Kn0ww/Sistema-de-riego-inteligente-por-zonas/README.md

# Sistema de riego inteligente por zonas
IoT-e1736873173433

## Objetivo
Diseñar e implementar un sistema de riego automático basado en IoT, capaz de monitorear la humedad del suelo y controlar el riego de manera independiente para 2 ZONAS validada por el docente de la sección.

## Integrantes
- David Morales  
- Alex Camacaro
- Sofia Aedo
- Mauricio Lobo
- Xavier Lopez
- Cristobal Barahona
  
## Hardware
- Microcontrolador ESP32
- 2 sensores de humedad HD-38
- Relé de 4 canales HW-316
- Mini bomba de agua R385 DC 5V
- Pantalla Oled 1.3 128x64 caracteres blancos
- Servomotor SG90
  
## Software
- Arduino IDE
- Mosquitto
- Telegraf
- InfluxDB
- Grafana
- Python + Pandas
- Node-RED

## Ventana del filtro
- N: 5, Se seleccionó porque para el sistema de riego se mide la humedad del suelo cada 60 segundos. La ventana de cinco muestras permite suavizar variaciones y ruido del sensor considerando aproximadamente cinco minutos de mediciones, sin generar un retraso excesivo para la decisión del riego.

## Sensores
- El valor de 0% a 100% que mostramos no es el porcentaje de volumen de agua real. Es un índice
relativo basado en la resistencia eléctrica del sustrato.
## Electrolisis
Para evitar la electrólisis, los sensores no quedan energizados permanentemente:
- Se alimentan directo desde un pin GPIO del ESP32 solo durante la medición, con 300 ms de estabilización previa, permaneciendo apagados el 99% del tiempo.
- Justificación de corriente: El sensor HD-38 consume ~10 mA al medir, valor muy inferior al límite seguro de 20-40 mA que entrega un pin GPIO del ESP32, operando con amplia holgura y haciendo innecesario un transistor externo.

## Verificación sensor simulado
| Parámetro | Simulación (GT1) | 
|---|---|
| m (ganancia) | 0.94883 |
| b (offset) | -1.955 |
| Tercer punto | dentro de tol. | 
---------------------------------------
- Tolerancia declarada sensor simulado: ±0.5 °C

## Sistema de riego

- Sensor: humedad de suelo resistivo | Familia: A 
- Referencia: dos condiciones conocidas, aire (0 %) y agua (100 %)
- Porcentaje humedad sensores(%): El sensor entrega un índice relativo de humedad para nuestro sustrato.
- Referencia validada por: docente de la sección
## Condiciones de la medición 
| Condición | Valor declarado |
|---|---|
| Tensión de alimentación MEDIDA | 3,2V (verificado con multímetro) |
| Canales empleados | Z1: GPIO 35, Z2: GPIO 34 |
| Atenuación del convertidor | 11 dB, lectura en mV calibrados de fabrica |
| Divisor a la entrada | NO se emplea (Porque el sensor se alimenta de 3,3V, por lo que la salida se mantiene dentro del rango considerado utilizable por el ADC en esta configuración) |
| Lectura en aire dentro de la zona útil | si |
| Tiempo de estabilización en cada punto | 10 s |
| Sustrato de cada zona | Z1: tierra  Z2: tierra |
| Profundidad de inserción | hasta 8cm |
| Temperatura ambiente | 20°C |
| N de la media móvil | 5 |

## Tolerancia declarada
| Criterio | Tolerancia aceptada |
|---|---|
| Dispersión aceptada en condición estable, por zona | ± 2% |
| Separación mínima exigida entre aire y agua | 1000mV |
| Reproducibilidad del punto de agua entre repeticiones | +/- 60 mV |

## Calibración de dos puntos
| Zona | mV en tierra seca | mV en tierra humeda | Separación (mV) | m (%/mV) | b (%) |
|---|---|---|---|---|---|
| 1 | 1060.1  | 420.4 | 639.7 | -0.156321  | 165.7188 |
| 2 | 1138.9  | 462.4 | 676.5 | -0.147820  | 168.3548 |

La pendiente m es NEGATIVA en ambas zonas: a mayor humedad, menor lectura.

## Reproducibilidad del punto de tierra humeda 
| Zona | Repetición 1 (mV) | Repetición 2 (mV) | Diferencia | Cabe en la tolerancia |
|---|---|---|---|---|
| 1 | 323 |  270 | 53 | si |
| 2 | 506 |  502 | 4 | si |

## Verificación en el tercer punto (tierra húmeda)
| Zona | mV  | Porcentaje (%) | Valor SIN recortar | Estable y repetible |
|---|-----|---|---|---|
| 1 | 782  | 71.3 | N/A | si |
| 2 | 719 | 62.1 | N/A | si |

## Dispersión medida 
| Zona | Condición registrada | Media (%) | Dispersión (%) | Banda minima (k x disp) |
|---|---|---|---|---|
| 1 | tierra humeda | 71.3 | 0.28 | 0.84 |
| 2 | tierra humeda | 62.1 | 0.20 | 0.60 |

- k declarado: 3

## Contraste con la GT1
| Aspecto | Simulacion (GT1) | Fisico (S4) |
|---|---|---|
| Origen del error | sembrado | propio de cada ejemplar |
| Numero de pares | 1 | 2, uno por zona |
| Desviacion observada | --- | <diferencia entre los tres pares> |

## Hallazgo del equipo
A partir de los ensayos realizados en condición de tierra húmeda, se registraron las siguientes métricas de dispersión y respuesta:

- Diferencia de medias: Se observó una separación de 9,2 puntos porcentuales entre la Zona 1 (71,3 %) y la Zona 2 (62,1 %).
- Dispersión observada: La Zona 2 presentó una dispersión de 0,28 %, mientras que la Zona 1 registró 0,20 %.
- Banda mínima teórica (k = 3):
  * Zona 1: 3 * 0,20 % = 0,60 %
  * Zona 2: 3 * 0,28 % = 0,84 %

Inicialmente se consideró necesario establecer una banda de histéresis diferenciada por zona debido a la discrepancia de dispersión entre ambos ejemplares. No obstante, en el firmware se implementó una banda de histéresis común de 10 puntos porcentuales (10 %) para ambas zonas.

Justificación técnica de la banda común en firmware:
Al contrastar la banda de 10 % del firmware frente al requerimiento teórico de cada sensor:
- En la Zona 1: 10 % / 0,60 % = 16,67 veces (~17 veces el mínimo requerido).
- En la Zona 2: 10 % / 0,84 % = 11,90 veces (~12 veces el mínimo requerido).

La banda configurada supera entre 12 y 17 veces el mínimo exigido por la dispersión experimental. Dado este amplio margen de holgura, cualquier fluctuación espuria o ruido de medición queda plenamente absorbido, evitando oscilaciones en la conmutación del actuador y la bomba sin necesidad de complejizar el firmware con umbrales independientes.

### Limitaciones registradas
- La escala construida vale para el ejemplar, el sustrato Y la profundidad de
  insercion declarados. Cambiar cualquiera de los tres obliga a recalibrar.
- La lectura se toma en milivolts calibrados de fabrica. El convertidor del
  ESP32 responde de forma util entre unos 150 y 2450 mV: fuera de ese rango la
  medicion se comprime o se recorta.
  
- El porcentaje informado es una posicion relativa entre aire y agua, no unM
  contenido volumetrico de agua medido contra patron.
- La dispersion registrada corresponde a la condicion declarada. En otra
  condicion, la dispersion puede ser distinta.
- P8 es un prototipo educativo.

## Tabla de Tópicos MQTT
| Nombre del Tópico | QoS | Retained | Descripción del Payload |
| :--- | :---: | :---: | :--- |
| `curso/E03/P08/nodo1` | 0 | True | Payload JSON plano con los datos de humedad calibrados y estados de las zonas Z1/Z2. |
| `curso/E03/P08/nodo1/estado` | 1 | True | Mensaje de texto plano indicando el estado de conexión. (Online, OfFline) |
| `curso/E03/P08/nodo1/cmd` | 1 | False | Reservado para la recepción de comandos de control entrantes (formato JSON). |

## Informacion Telegraf

```text
ESP32 -> MQTT -> Mosquitto -> Telegraf -> InfluxDB -> Grafana
```

1. El ESP32 obtiene las mediciones de los sensores.
2. Las mediciones se publican mediante MQTT.
3. Mosquitto recibe los mensajes MQTT.
4. Telegraf consume los tópicos MQTT y procesa los datos.
5. Telegraf almacena los datos en InfluxDB.
6. Grafana consulta InfluxDB para visualizar las métricas.

```text
Bucket: mediciones
Measurement: mediciones
```

| Tag | Valor |
| :--- | :--- |
| `equipo` | `E03` |
| `proyecto` | `P08` |
| `nodo` | `nodo1` |

## Fields del Proyecto

| Field | Descripción |
| :--- | :--- |
| `humedad_z1` | Humedad medida en la zona 1. |
| `humedad_z2` | Humedad medida en la zona 2. |
| `estado_z1` | Estado actual de la zona 1. |
| `estado_z2` | Estado actual de la zona 2. |
| `rssi_dbm` | Intensidad de la señal WiFi recibida por el ESP32 en dBm. |
