Kn0ww/Sistema-de-riego-inteligente-por-zonas/docs/Grafo de estados .png

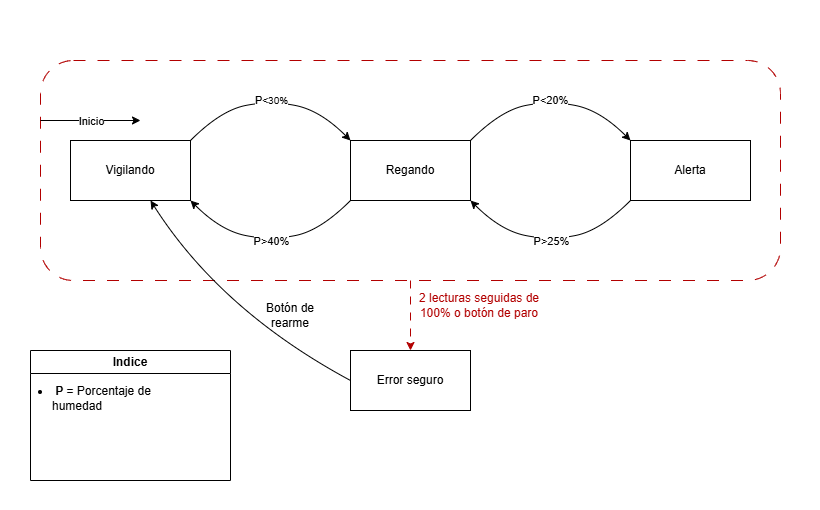
docs/Grafo de estados .png
