Kn0ww/Sistema-de-riego-inteligente-por-zonas/docs/InfografanaGT5.png

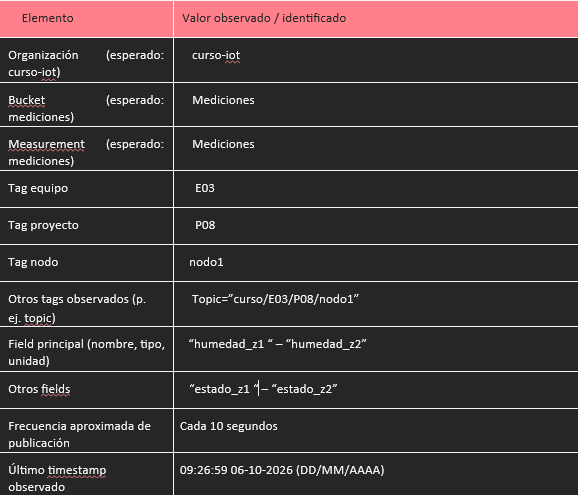
docs/InfografanaGT5.png
