Kn0ww/Sistema-de-riego-inteligente-por-zonas/docs/S3_Ficha_alimentacion_nodo_Rev.xlsx

Sheet: Instrucciones
FICHA DE ALIMENTACIÓN DEL NODO — GT1, ítem 7
Fundamentos de IoT · 2º semestre 2026 · Universidad Autónoma de Chile
QUÉ SE COMPLETA
Solo las celdas con fondo azul de la hoja «Ficha». Todo lo demás son fórmulas: no se escribe encima.
PASOS
1. Completar la identificación del equipo y los parámetros del ciclo (período, rieles, batería).
2. Listar TODOS los componentes del nodo, uno por fila, con su corriente activa, su corriente en reposo y
cuántos segundos permanece activo dentro de un período. La fila de ejemplo muestra el formato esperado:
bórrenla o sustitúyanla por sus propios componentes.
3. Indicar de dónde salió cada cifra: hoja de datos del componente o medición propia. Un número sin fuente
no se acepta en el ítem 7.
4. Registrar la corriente de pico de cada componente. La planilla identifica sola cuál domina.
5. Declarar si el nodo va enchufado o a batería, y justificarlo en una línea.
6. Guardar la planilla en la carpeta /docs del repositorio del equipo.
CÓMO SE CALCULA
Corriente media ponderada por el ciclo de trabajo: I_media = Σ [ I_activa·t_activo + I_reposo·(T − t_activo) ] / T
Corriente exigida a la batería con conversión reductora: I_bat = I_media · (V_riel / V_bat) / η
Autonomía: t = (0,8 · C_nominal) / I_bat (el factor 0,8 es la capacidad útil, no la nominal)
ADVERTENCIAS QUE CUESTAN EL ÍTEM
· La corriente de pico no es opcional: es la que reinicia el nodo cuando transmite. Sin ella, el ítem 7 no cumple.
· El consumo en reposo de una PLACA DE DESARROLLO es de unidades de mA, no de microamperios. Usar la cifra del
módulo desnudo produce una autonomía entre diez y cien veces optimista.
· Una celda 18650 que declara más de 3500 mAh no es creíble. Usar una capacidad defendible y anotar el supuesto.
· Si el proyecto exige nodo publicando de forma permanente (Semana 10), la autonomía debe ser compatible con eso
o el nodo va enchufado. Decidirlo ahora es más barato que descubrirlo en la Semana 10.

Sheet: Ficha
FICHA DE ALIMENTACIÓN DEL NODO
Completar solo las celdas con fondo azul. GT1, ítem 7.
Equipo (código E NN) | E03
Proyecto (código P NN) | P8
Sección de laboratorio | LAB 01
Fecha | 2026-08-14
PARÁMETROS DEL CICLO Y DE LA FUENTE
Período del ciclo del nodo T [s] | 60 | Tiempo entre dos mediciones completas.
Tensión del riel principal V_riel [V] | 5 | Riel que alimenta el nodo.
Tensión nominal de la batería V_bat [V] | 7.4 | 2 celdas 18650 en serie = 7,4 V.
Rendimiento del conversor η | 0.85 | Conversor reductor. 0,85 es un valor conservador.
Capacidad nominal de la batería C_nom [mAh] | 2600 | Capacidad defendible, no la de la etiqueta si es implausible.
Factor de capacidad útil | 0.8 | No se descarga una celda al 100 %.
CONSUMO POR COMPONENTE
Componente | Riel [V] | I activa [mA] | I reposo [mA] | t activo por ciclo [s] | I de pico [mA] | Aporte a I media [mA] | Fuente del dato | ¿Riel propio?
ESP32 DevKit — CPU activa, radio apagada | 5 V | 120 | 10 | 60 | 300 | 120.00 | Hoja de datos del módulo | No
Sensor de humedad HD-38 | 3,3V | 30 | 0 | 10 | 30 | 5.00 | Especificaciones MechatronicStore | No
Sensor de humedad HD-38 | 3,3V | 30 | 0 | 10 | 30 | 5.00 | Especificaciones MechatronicStore | No
Pantalla OLED | 3V | 10 | 1.5 | 10 | 30 | 2.92 | Especificaciones AFEL | No
Relé SRD-05VDC-SL-C | 5V | 89.3 | 0 | 10 | 89.3 | 14.88 | Datasheet SRD-05VDC-SL-C: | No
Mini bomba de agua | 5V | 220 | 0 | 10 | 600 | 36.67 | Especificaciones MCI Electronics | Si
Servomotor SG90 9g | 5V | 220 | 0 | 2 | 650 | 7.33 | Datasheet SG90 9g | Si
RESULTADOS
Corriente media del nodo I_media [mA] | 191.80
Corriente de pico máxima [mA] | 650
Componente que produce el pico | Servomotor SG90 9g
Corriente exigida a la batería I_bat [mA] | 152.46
Capacidad útil [mAh] | 2080
Autonomía estimada [h] | 13.6
Autonomía estimada [días] | 0.6
DECISIÓN DE ALIMENTACIÓN
¿El nodo va enchufado o a batería? | Batería
Justificación en una línea | Se utiliza batería ya que permite que el sistema de riego sea autónomo y portátil, evitando depender de un enchufe cercano.
¿Hay actuadores con riel propio? ¿Cuáles? | Si hay actuadores con riel propio. el Servo motor y Mini Bomba de agua utilizan un riel de 5 V.
¿Usa deep sleep? ¿Es compatible con la publicación permanente (S10)? | No usaremos deep sleep, ya que usaremos comandos remotos de riego Node-RED, por lo que requerimos que el nodo permaneza despierto todo el tiempo.
Supuestos declarados (capacidad de celda, consumo en reposo, etc.) | Servo motor (t_activo por ciclo [s] = 2 s), Mini bomba (t_activo por ciclo [s] = 10 s), Rele (t_activo por ciclo [s] = 10 s), Pantalla LCD (I reposo) se contemplo que cuando el LCD esta activo con la luz tiene esas especificaciones pero cuando no la corriente baja a 1,5 por lo que se considero en reposo ya que no estara activo o al menos activo con luz como se espera. Otro supuesto el ESP32 ya que no teniamos el modelo por ende usamos por referencia.
Nota: las cifras de la fila de ejemplo son órdenes de magnitud para ilustrar el formato. Cada equipo debe sustituirlas por los valores de la hoja de datos de sus propios componentes o por mediciones propias, indicando la fuente.

Sheet: Referencia
ÓRDENES DE MAGNITUD DE CONSUMO (referencia para dimensionar)
Valores de orden de magnitud, no de diseño. El valor definitivo se toma de la hoja de datos del componente del kit y se registra con su fuente.
Componente | Corriente típica | Comentario
ESP32 DevKit — CPU activa, radio apagada | decenas de mA | Estado habitual entre muestras.
ESP32 — transmisión WiFi | picos de cientos de mA | Pico de milisegundos; es el que reinicia nodos mal alimentados.
ESP32 DevKit — deep sleep | unidades de mA | El conversor USB-serie y el LED de la placa siguen consumiendo.
Módulo ESP32 desnudo — deep sleep | decenas de µA | No usar esta cifra si el proyecto usa placa de desarrollo.
Sensor digital de temperatura/humedad | 1–2 mA al medir | Despreciable frente al resto.
Sensor ultrasónico | ~15 mA | Solo durante la medición.
Pantalla OLED | 10–20 mA | Continuo mientras esté encendida.
Sensor de gas con calefactor (familia MQ) | ~150 mA continuos | Domina el presupuesto; incompatible con batería pequeña.
Módulo de relé (una bobina) | ~70 mA por canal | Se multiplica por canal simultáneo.
Servomotor pequeño | decenas de mA en reposo; cientos en movimiento | Pico de arranque muy superior al promedio. Riel propio.
Electroválvula solenoide 12 V | cientos de mA mientras está abierta | Riel propio; no accionar varias en simultáneo.
Módulo de cámara | cientos de mA en transmisión | Causa clásica de reinicio por caída de riel.
Fuente: hojas de datos de los fabricantes de los componentes del kit y cápsula asincrónica «Alimentación del nodo» (Semana 3).
