Kn0ww/Sistema-de-riego-inteligente-por-zonas/code/FSM_1_Zona.ino

/* =========================================================================
   PROYECTO: Sistema de Riego Automatizado con ESP32
   FSM:
   VIGILANDO
      P < 30%  -> REGANDO
   REGANDO
      P > 40%  -> VIGILANDO
      P < 20%  -> ALERTA
   ALERTA
      P > 25%  -> REGANDO
   ERROR_SEGURO
      2 lecturas seguidas al 100% o botón de paro
      botón de rearme -> VIGILANDO
========================================================================= */
#include <Wire.h>
#include <LiquidCrystal_I2C.h>
// ==========================================================================
// 1. PINES
// ==========================================================================
const uint8_t PIN_SENSOR_HUMEDAD = 34;  // ADC1
const uint8_t PIN_ENERGIA_SENSOR = 32;  
const uint8_t PIN_RELE           = 26;
const uint8_t PIN_LED_VERDE      = 14;
const uint8_t PIN_LED_ROJO       = 27;
const uint8_t PIN_BUZZER         = 25;
const uint8_t PIN_BOTON          = 33;
// ==========================================================================
// 2. RELÉ
// ==========================================================================
const uint8_t RELE_ON  = LOW; // LOW  = relé activado
const uint8_t RELE_OFF = HIGH; // HIGH = relé desactivado
// 3. LCD
// ==========================================================================
LiquidCrystal_I2C lcd(0x27, 16, 2);
// ==========================================================================
// 4. ADQUISICIÓN Y FILTRADO
// ==========================================================================
// Periodo de muestreo: 60000 ms = 1 minuto
const uint8_t N_FILTRO = 5; // Media móvil de 5 muestras
// Calibración de sensor -> % = M * mV + B
const float M = -0.0454236f;
const float B = 141.9032f;
// Rango útil observado en la calibración
const int MV_MAXIMO_UTIL = 2450;
const int MV_MINIMO_UTIL = 150;
// ==========================================================================
// 5. UMBRALES DE LA FSM
// ==========================================================================
const float P_VIGILANDO_REGANDO = 30.0f;
const float P_REGANDO_VIGILANDO = 40.0f;

const float P_REGANDO_ALERTA    = 20.0f;
const float P_ALERTA_REGANDO    = 25.0f;
// ==========================================================================
// 6. MÁQUINA DE ESTADOS
// ==========================================================================
enum Estado : uint8_t {
  VIGILANDO,
  REGANDO,
  ALERTA,
  ERROR_SEGURO
};
Estado estado = VIGILANDO;
// ==========================================================================
// 7. TEMPORIZACIÓN
// ==========================================================================
uint32_t t_entrada = 0; // Marca guardada al entrar al estado.
uint32_t t_sensor = 0; // Temporización del sensor
uint32_t t_boton = 0; // Temporización del botón para antirrebote
const uint32_t DEBOUNCE_MS = 50;
uint32_t t_buzzer = 0; // Temporización del buzzer
const uint32_t PERIODO_BUZZER_MS = 300;
bool buzzerEstado = false;
uint32_t t_lcd = 0;
const uint32_t PERIODO_LCD_MS = 250;
// ==========================================================================
// 8. FILTRO
// ==========================================================================
int ventana[N_FILTRO] = {0};
uint8_t indiceFiltro = 0;
bool filtroLleno = false;
// ==========================================================================
// 9. VARIABLES DEL SENSOR Y SUB-MÁQUINA
// ==========================================================================
enum EstadoSensor : uint8_t {
  SENSOR_REPOSO,
  SENSOR_ESPERANDO_300MS
};

EstadoSensor estadoSensor = SENSOR_REPOSO;
uint32_t t_encendido_sensor = 0;

int lecturaCruda_mV = 0;
int lecturaFiltrada_mV = 0;

float humedadPorcentaje = 0.0f;
float humedadSinRecortar = 0.0f;
// ==========================================================================
// 10. ERROR POR PERSISTENCIA
uint8_t lecturas100 = 0; // Se necesitan 2 lecturas consecutivas al 100%.
// ==========================================================================
// 11. ESTADO DEL BOTÓN
bool botonEstable = HIGH;
bool botonAnterior = HIGH;
// ==========================================================================
// 12. LEER SENSOR EN mV
int leer_mV() {
  long suma = 0;
  // Promedio de 8 lecturas para reducir variación instantánea
  for (uint8_t i = 0; i < 8; i++) {
    suma += analogReadMilliVolts(PIN_SENSOR_HUMEDAD);
  }
  return (int)(suma / 8);
}
// ==========================================================================
// 13. FILTRO DE MEDIA MÓVIL
// ==========================================================================
int filtrar(int valor) {
  ventana[indiceFiltro] = valor;

  indiceFiltro = (indiceFiltro + 1) % N_FILTRO;
  if (indiceFiltro == 0) {
    filtroLleno = true;
  }
  uint8_t cantidad;
  if (filtroLleno) {
    cantidad = N_FILTRO;
  } else {
    cantidad = indiceFiltro;
  }
  if (cantidad == 0) {
    cantidad = 1;
  }
  long suma = 0;
  for (uint8_t i = 0; i < cantidad; i++) {
    suma += ventana[i];
  }
  return (int)(suma / cantidad);
}
// ==========================================================================
// 14. CONVERSIÓN mV -> PORCENTAJE
// ==========================================================================
float convertirPorcentaje(int mv) {
  float porcentaje = M * mv + B;   // Guardamos el valor sin limitar para diagnóstico
  humedadSinRecortar = porcentaje;
  if (porcentaje < 0.0f) {  // Limitar al rango 0 ... 100 %
    porcentaje = 0.0f;
  }
  if (porcentaje > 100.0f) {
    porcentaje = 100.0f;
  }
  return porcentaje;
}
// ==========================================================================
// 15. NOMBRE DEL ESTADO
// ==========================================================================
const char* nombreEstado(Estado e) {
  switch (e) {
    case VIGILANDO:
      return "VIGILANDO";
    case REGANDO:
      return "REGANDO";
    case ALERTA:
      return "ALERTA";
    case ERROR_SEGURO:
      return "ERROR_SEGURO";
  }
  return "DESCONOCIDO";
}
// ==========================================================================
// 16. CAMBIO DE ESTADO
// ==========================================================================
void cambiar(Estado nuevoEstado) { // ÚNICA función que cambia "estado". También reinicia el temporizador de entrada.
  if (estado == nuevoEstado) {
    return;
  }
  estado = nuevoEstado;
  t_entrada = millis(); // Marca de entrada al nuevo estado
  t_buzzer = millis(); // Reiniciar temporizador del buzzer
  buzzerEstado = false;
  digitalWrite(PIN_BUZZER, LOW);
  Serial.print("[");
  Serial.print(millis());
  Serial.print(" ms] -> ");
  Serial.println(nombreEstado(estado));
}
// =========================================================================
// 17. BOTÓN CON ANTIRREBOTE
// ==========================================================================
bool botonPresionado() {
  bool lectura = digitalRead(PIN_BOTON);
  if (lectura != botonAnterior) {
    t_boton = millis();
    botonAnterior = lectura;
  }
  if (millis() - t_boton >= DEBOUNCE_MS) {   // Esperar solamente mediante millis()
    if (lectura != botonEstable) {
      botonEstable = lectura;
      if (botonEstable == LOW) {  // LOW = botón presionado
        return true;
      }
    }
  }
  return false;
}
// ==========================================================================
// 18. BUZZER INTERMITENTE
// ==========================================================================
void buzzerIntermitente() {
  uint32_t ahora = millis();
  if (ahora - t_buzzer >= PERIODO_BUZZER_MS) { // Temporización no bloqueante
    t_buzzer = ahora;
    buzzerEstado = !buzzerEstado;
    digitalWrite(PIN_BUZZER, buzzerEstado);
  }
}
// ==========================================================================
// 19. ACTUADORES
// ==========================================================================
void actualizarActuadores() {
  switch (estado) {
    case VIGILANDO: // VIGILANDO
      digitalWrite(PIN_RELE, RELE_OFF);
      digitalWrite(PIN_LED_VERDE, HIGH);
      digitalWrite(PIN_LED_ROJO, LOW);
      digitalWrite(PIN_BUZZER, LOW);
      break;
    case REGANDO: // REGANDO
      digitalWrite(PIN_RELE, RELE_ON);
      digitalWrite(PIN_LED_VERDE, HIGH);
      digitalWrite(PIN_LED_ROJO, LOW);
      digitalWrite(PIN_BUZZER, LOW);
      break;
    case ALERTA: // ALERTA
      digitalWrite(PIN_RELE, RELE_ON);
      digitalWrite(PIN_LED_VERDE, LOW);
      digitalWrite(PIN_LED_ROJO, HIGH);
      buzzerIntermitente();
      break;
    case ERROR_SEGURO: // ERROR SEGURO
      // Salida segura:
      // relé apagado
      digitalWrite(PIN_RELE, RELE_OFF);
      digitalWrite(PIN_LED_VERDE, LOW);
      digitalWrite(PIN_LED_ROJO, HIGH);
      buzzerIntermitente();
      break;
  }
}
// ==========================================================================
// 20. LCD
// ==========================================================================
void actualizarLCD() {
  uint32_t ahora = millis();

  if (ahora - t_lcd >= PERIODO_LCD_MS) {  // Temporizador del LCD
    t_lcd = ahora;
    lcd.setCursor(0, 0);     // Primera fila
    lcd.print("Humedad: ");
    lcd.print(humedadPorcentaje, 1);
    lcd.print("%   ");

    lcd.setCursor(0, 1);     // Segunda fila
    switch (estado) {
      case VIGILANDO:
        lcd.print("Vigilando      ");
        break;
      case REGANDO:
        lcd.print("Regando        ");
        break;
      case ALERTA:
        lcd.print("ALERTA         ");
        break;
      case ERROR_SEGURO:
        lcd.print("ERROR SEGURO   ");
        break;
    }
  }
}
// ==========================================================================
// 21. ACTUALIZACIÓN DEL SENSOR (SUB-MÁQUINA)
// ==========================================================================
void actualizarSensor() {
  uint32_t ahora = millis();
  uint32_t periodoActual; //LÓGICA DE TIEMPO DINÁMICO
  if (estado == VIGILANDO) {
    periodoActual = 60000; // 60 segundos (1 minuto) en VIGILANDO
  } else {
    periodoActual = 1000;  // 1 segundo en el resto de estados
  }
  switch (estadoSensor) {
    case SENSOR_REPOSO: // CASO 1: El sensor está apagado esperando su turno
      if (ahora - t_sensor >= periodoActual) { // Usamos la variable dinámica "periodoActual"
        t_sensor = ahora; 
        digitalWrite(PIN_ENERGIA_SENSOR, HIGH); // ENCENDER SENSOR
        t_encendido_sensor = ahora;
        estadoSensor = SENSOR_ESPERANDO_300MS;
      }
      break;
    case SENSOR_ESPERANDO_300MS: // CASO 2: El sensor está encendido, esperando estabilizarse
      if (ahora - t_encendido_sensor >= 300) {
        lecturaCruda_mV = leer_mV(); // MEDIR Y APAGAR SENSOR
        digitalWrite(PIN_ENERGIA_SENSOR, LOW);
        lecturaFiltrada_mV = filtrar(lecturaCruda_mV); // Filtrado y conversión
        humedadPorcentaje = convertirPorcentaje(lecturaFiltrada_mV);
        if (humedadPorcentaje >= 99.9f) {  // Diagnóstico de dos lecturas al 100 %
          lecturas100++;
        } else {
          lecturas100 = 0;
        }
        Serial.print(" mV | Humedad: "); // Monitor serie
        Serial.print(humedadPorcentaje, 1);
        Serial.println(" %");
        estadoSensor = SENSOR_REPOSO;  // Volver al estado de reposo para el siguiente ciclo
      }
      break;
  }
}
// ==========================================================================
// 22. LÓGICA DE LA FSM
// ==========================================================================
void ejecutarFSM() {
  // EVENTOS GLOBALES - Aplican desde cualquier estado excepto ERROR_SEGURO
  if (estado != ERROR_SEGURO) {
    if (botonPresionado()) { // Botón de paro
      cambiar(ERROR_SEGURO);
      return;
    }
    if (lecturas100 >= 2) { // Dos lecturas consecutivas al 100 %
      lecturas100 = 0;
      cambiar(ERROR_SEGURO);
      return;
    }
  }
  // ========================================================================
  // FSM: UN CASE POR CADA ESTADO
  // ========================================================================
  switch (estado) {
    case VIGILANDO: // VIGILANDO
      if (humedadPorcentaje < P_VIGILANDO_REGANDO) { // P < 30 % -> REGANDO
        cambiar(REGANDO);
      }
      break;
    case REGANDO: // REGANDO
      if (humedadPorcentaje > P_REGANDO_VIGILANDO) { // P > 40 % -> VIGILANDO
        cambiar(VIGILANDO);
      }
      else if (humedadPorcentaje < P_REGANDO_ALERTA) { // P < 20 % -> ALERTA
        cambiar(ALERTA);
      }
      break;
    case ALERTA: // ALERTA
      if (humedadPorcentaje > P_ALERTA_REGANDO) { // P > 25 % -> REGANDO
        cambiar(REGANDO);
      }
      break;
    // ======================================================================
    // ERROR SEGURO
    // ======================================================================
    case ERROR_SEGURO: // El sistema permanece aquí hasta recibir el botón de rearme.
      if (botonPresionado()) { // Reiniciar contador de fallas
        lecturas100 = 0;
        cambiar(VIGILANDO);
      }
      break;
  }
}
// ==========================================================================
// 23. SETUP
// ==========================================================================
void setup() {
  Serial.begin(115200);
  analogSetPinAttenuation( // Sensor ADC
    PIN_SENSOR_HUMEDAD,
    ADC_11db
  );
  // Salidas
  pinMode(PIN_RELE, OUTPUT); 
  pinMode(PIN_LED_VERDE, OUTPUT);
  pinMode(PIN_LED_ROJO, OUTPUT);
  pinMode(PIN_BUZZER, OUTPUT);
  pinMode(PIN_ENERGIA_SENSOR, OUTPUT);
  digitalWrite(PIN_ENERGIA_SENSOR, LOW); // Inicia apagado
  pinMode(PIN_BOTON, INPUT_PULLUP);  // Botón
  // Estado seguro inicial
  digitalWrite(PIN_RELE, RELE_OFF);
  digitalWrite(PIN_LED_VERDE, LOW);
  digitalWrite(PIN_LED_ROJO, LOW);
  digitalWrite(PIN_BUZZER, LOW);
  // LCD
  lcd.init();
  lcd.backlight();
  lcd.clear();
  lcd.setCursor(0, 0);
  lcd.print("Sistema riego");
  lcd.setCursor(0, 1);
  lcd.print("FSM iniciada");
  // Inicialización del temporizador del estado
  t_entrada = millis();
  t_sensor = millis();
  t_boton = millis();
  t_buzzer = millis();
  // Estado inicial
  estado = VIGILANDO;
  Serial.println();
  Serial.println("==========================================");
  Serial.println(" SISTEMA DE RIEGO - FSM");
  Serial.println("==========================================");
  Serial.println("Estado inicial: VIGILANDO");
  Serial.println("Sensor: GPIO34");
  Serial.println("Filtro: media movil N=5");
  Serial.println("Muestreo: 60000 ms");
  Serial.println("Sin delay()");
  Serial.println("==========================================");
}
// ==========================================================================
// 24. LOOP PRINCIPAL
// ==========================================================================
void loop() {
  uint32_t ahora = millis();
  actualizarSensor(); // 1. SENSOR
  ejecutarFSM(); // 2. FSM
  actualizarActuadores(); // 3. ACTUADORES
  actualizarLCD(); // 4. LCD
  // 5. TEMPORIZADOR DEL ESTADO. Se consulta en CADA vuelta del loop y no bloquea el programa.
  uint32_t tiempoEnEstado = ahora - t_entrada;
  // Esta variable permite comprobar cuánto tiempo lleva el sistema dentro del estado actual.
  (void)tiempoEnEstado;
}
