Kn0ww/Sistema-de-riego-inteligente-por-zonas/(commit log)

2026-08-14 Comentarios sobre la diferencias del valor calibrado y filtrado.Justificacion de la utilizacion de 60.000ms
2026-08-16 Update README with new components and formatting fix
    Added 2 batteries and corrected the formatting of the servomotor entry.
2026-08-20 Rename Grafo de estados .png to docs/Grafo de estados .png
2026-08-28 Adjust sensor offset and error simulation values
    [ENN_GT1.ino]
2026-08-28 Update irrigation control method to use servomotor
    Replaced solenoid valve system with a 5V servomotor to control irrigation zones.
    [ENN_GT1.ino]
2026-09-08 Update calibration and reproducibility data in README
2026-10-01 Update calibration constants for sensors
2026-10-21 el pepe
2026-10-22 codigo nuevo servo y oled pro max
